kafka-on-the-shore/3dcomponents/MecanumWheel/images/13eef254c127c62518d9d03d0647d64a_preview_featured.jpg

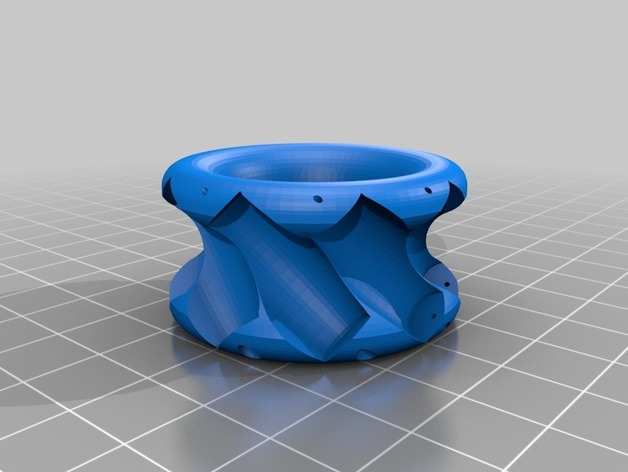
MecanumWheel/images/13eef254c127c62518d9d03d0647d64a_preview_featured.jpg
