kafka-on-the-shore/3dcomponents/MecanumWheel/images/b12311517630522f4fafc9a8f9769c80_preview_featured.jpg

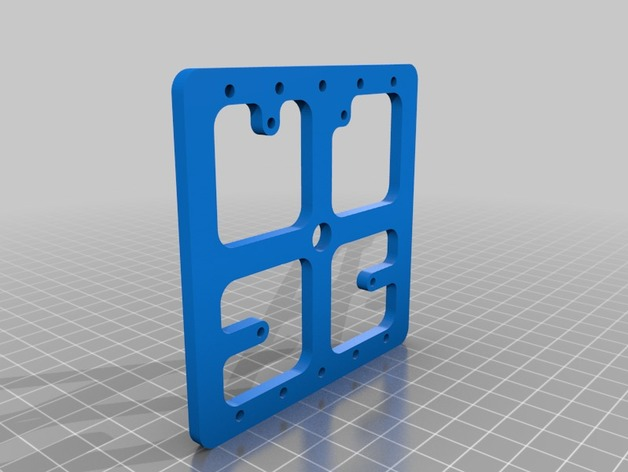
MecanumWheel/images/b12311517630522f4fafc9a8f9769c80_preview_featured.jpg
