kafka-on-the-shore/3dcomponents/MecanumWheel/images/41f200ae12cc2517c2021ea4bbecb6a7_preview_featured.jpg

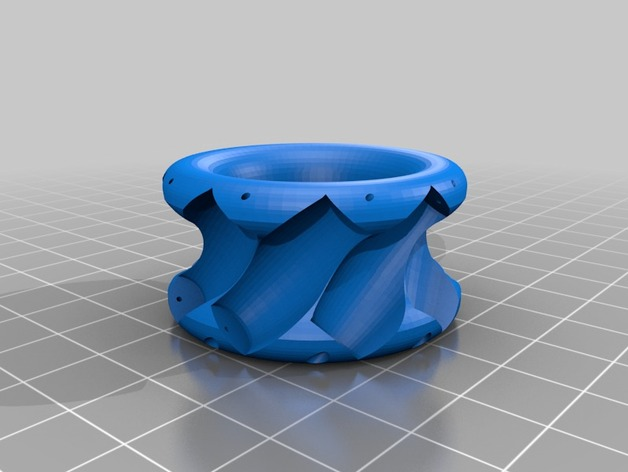
MecanumWheel/images/41f200ae12cc2517c2021ea4bbecb6a7_preview_featured.jpg
