kafka-on-the-shore/3dcomponents/MecanumWheel/images/62bf1edb36141f114521ec4bb4175579_preview_featured.jpg

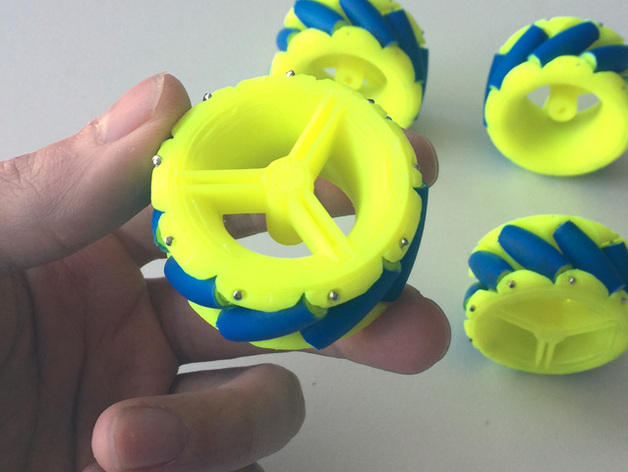
MecanumWheel/images/62bf1edb36141f114521ec4bb4175579_preview_featured.jpg
