kafka-on-the-shore/3dcomponents/MecanumWheel/images/86d09d657bddbb333977ce796d3afcb8_preview_featured.JPG

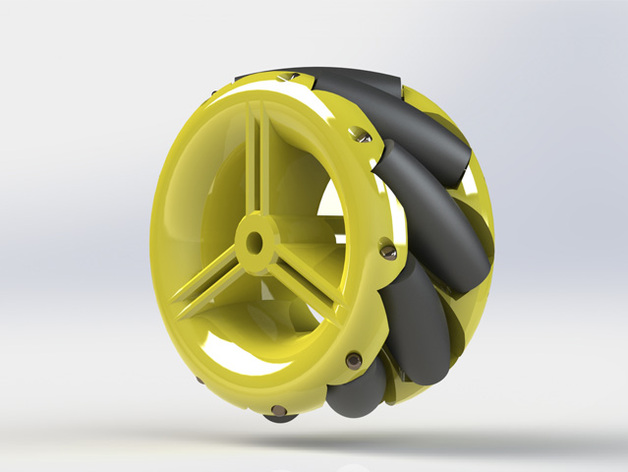
MecanumWheel/images/86d09d657bddbb333977ce796d3afcb8_preview_featured.JPG
