kafka-on-the-shore/3dcomponents/MecanumWheel/images/1110f6a29720a63f037c882c2db465c6_preview_featured.jpg

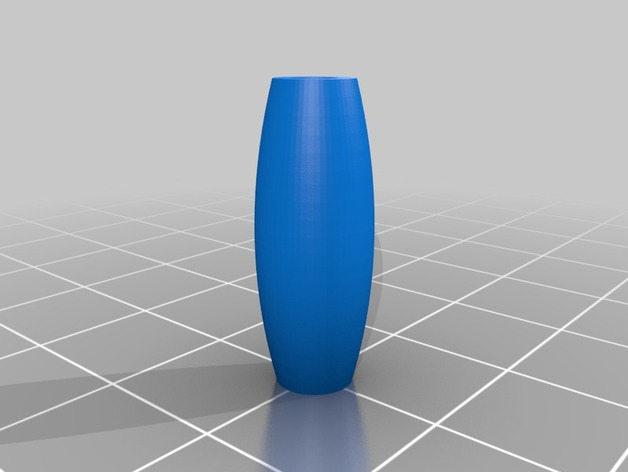
MecanumWheel/images/1110f6a29720a63f037c882c2db465c6_preview_featured.jpg
