kafka-on-the-shore/3dcomponents/MecanumWheel/images/94201f7ce94ead6c6871e449a47c7c70_preview_featured.jpg

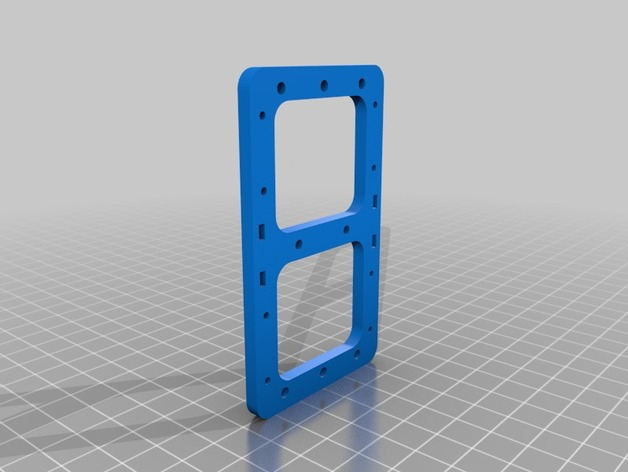
MecanumWheel/images/94201f7ce94ead6c6871e449a47c7c70_preview_featured.jpg
