kafka-on-the-shore/3dcomponents/MecanumWheel/images/d5da9ced678858c8c6ee1cd3d8c055d4_preview_featured.jpg

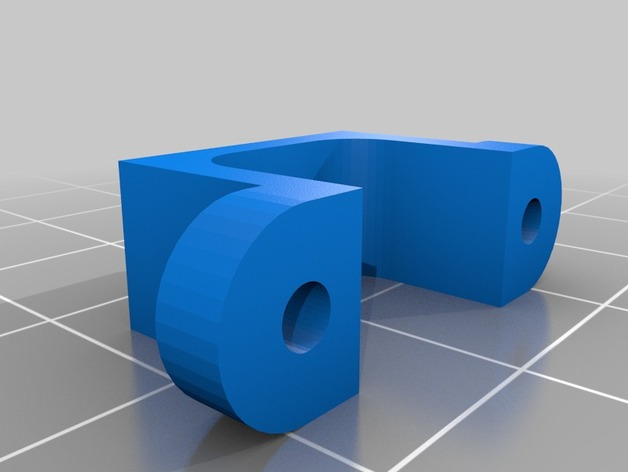
MecanumWheel/images/d5da9ced678858c8c6ee1cd3d8c055d4_preview_featured.jpg
