kafka-on-the-shore/3dcomponents/MecanumWheel/files/bottom.STL

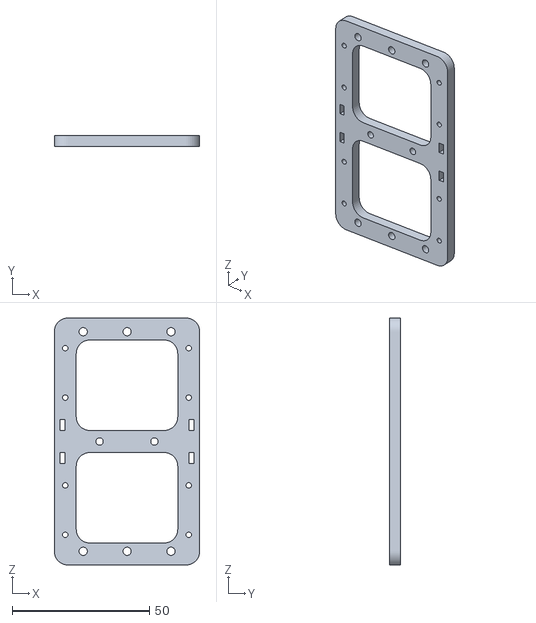
[picture p9: CAD file, 2019-06-07]
MecanumWheel/files/bottom.STL
53.0 x 4.00 x 90.0
