kafka-on-the-shore/3dcomponents/MecanumWheel/files/Body_Left.STL

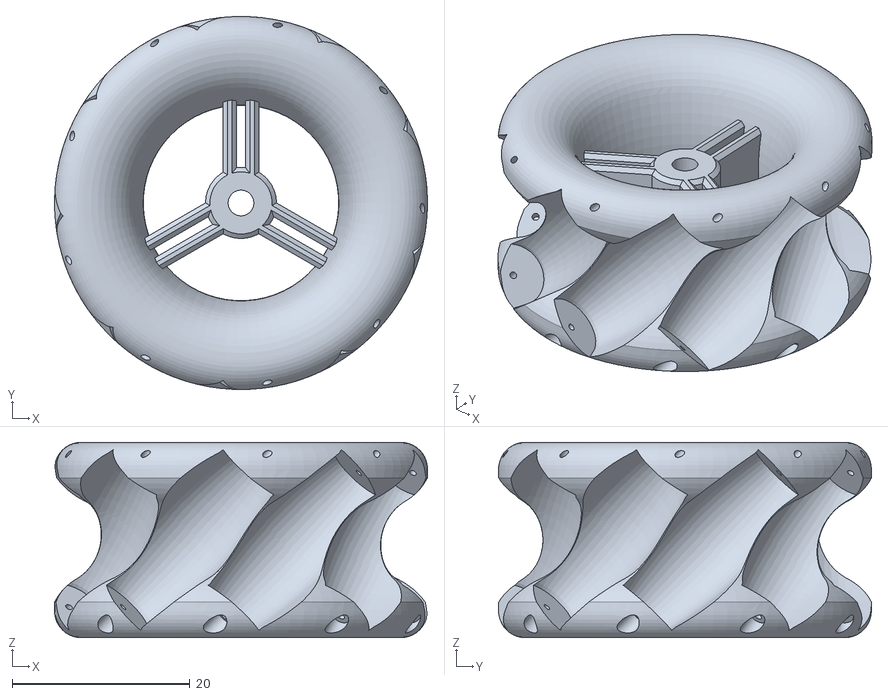
[picture p10: CAD file, 2019-06-07]
MecanumWheel/files/Body_Left.STL
42.0 x 42.0 x 22.0
