kafka-on-the-shore/3dcomponents/MecanumWheel/files/Top.STL

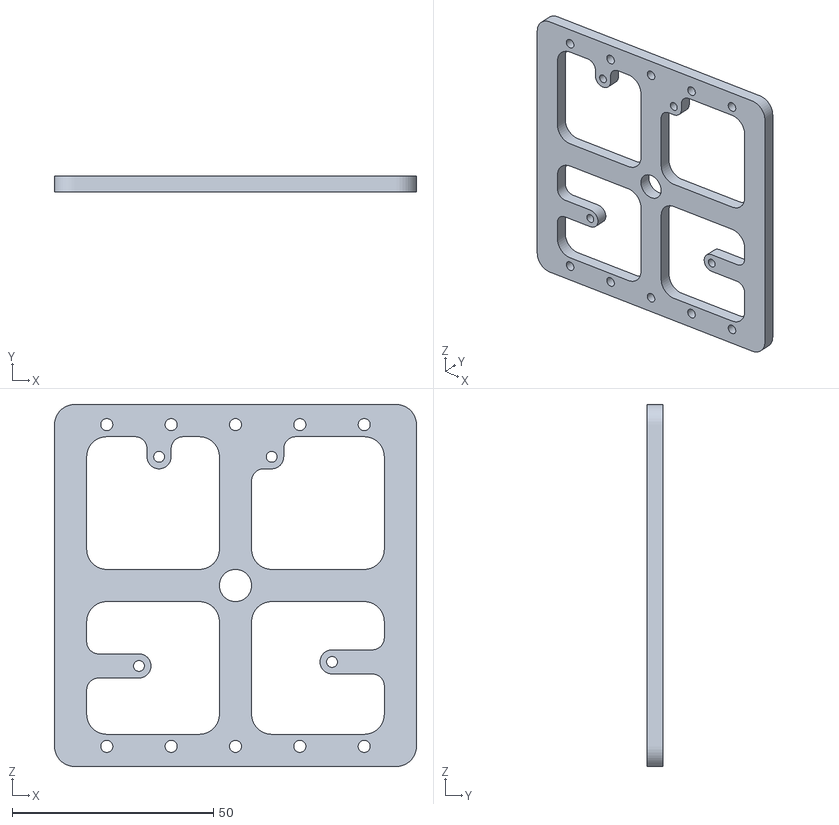
[picture p11: CAD file, 2019-06-07]
MecanumWheel/files/Top.STL
90.0 x 4.00 x 90.0
