kafka-on-the-shore/3dcomponents/MecanumWheel/files/Roller9_v2.stl

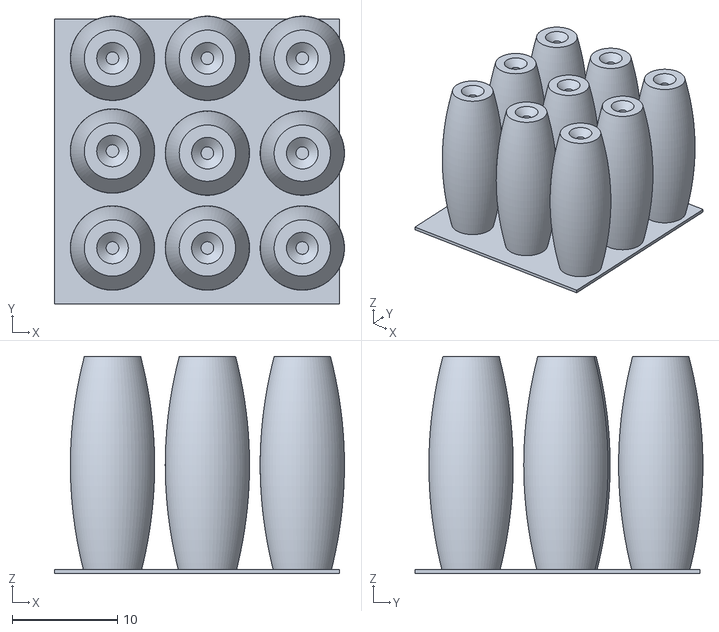
[picture p12: CAD file, 2019-06-07]
MecanumWheel/files/Roller9_v2.stl
27.5 x 27.3 x 20.6
