kafka-on-the-shore/3dcomponents/MecanumWheel/files/Motor_Mount.STL

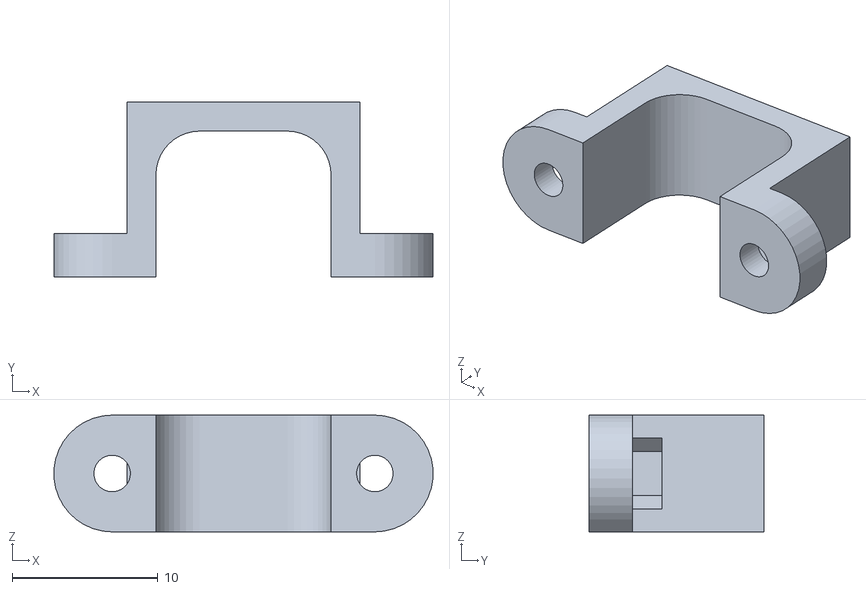
[picture p13: CAD file, 2019-06-07]
MecanumWheel/files/Motor_Mount.STL
26.0 x 12.0 x 8.00
