kafka-on-the-shore/3dcomponents/MecanumWheel/files/Roller.STL

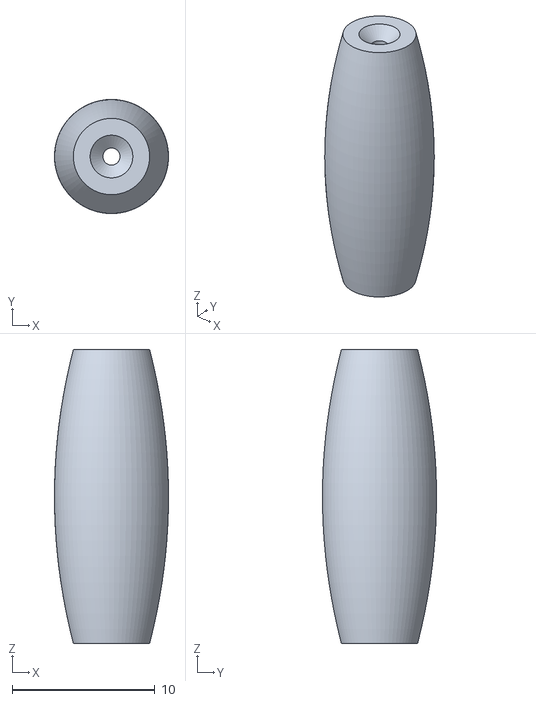
[picture p14: CAD file, 2019-06-07]
MecanumWheel/files/Roller.STL
8.00 x 7.99 x 20.6
