kafka-on-the-shore/3dcomponents/(list of files, cad)

Other CAD files:
MecanumWheel/files/Body_Right.STL
